Jesus-InC/Sistema-Domotico-Inteligente/docs/pcb/docs/Esquematico.pdf

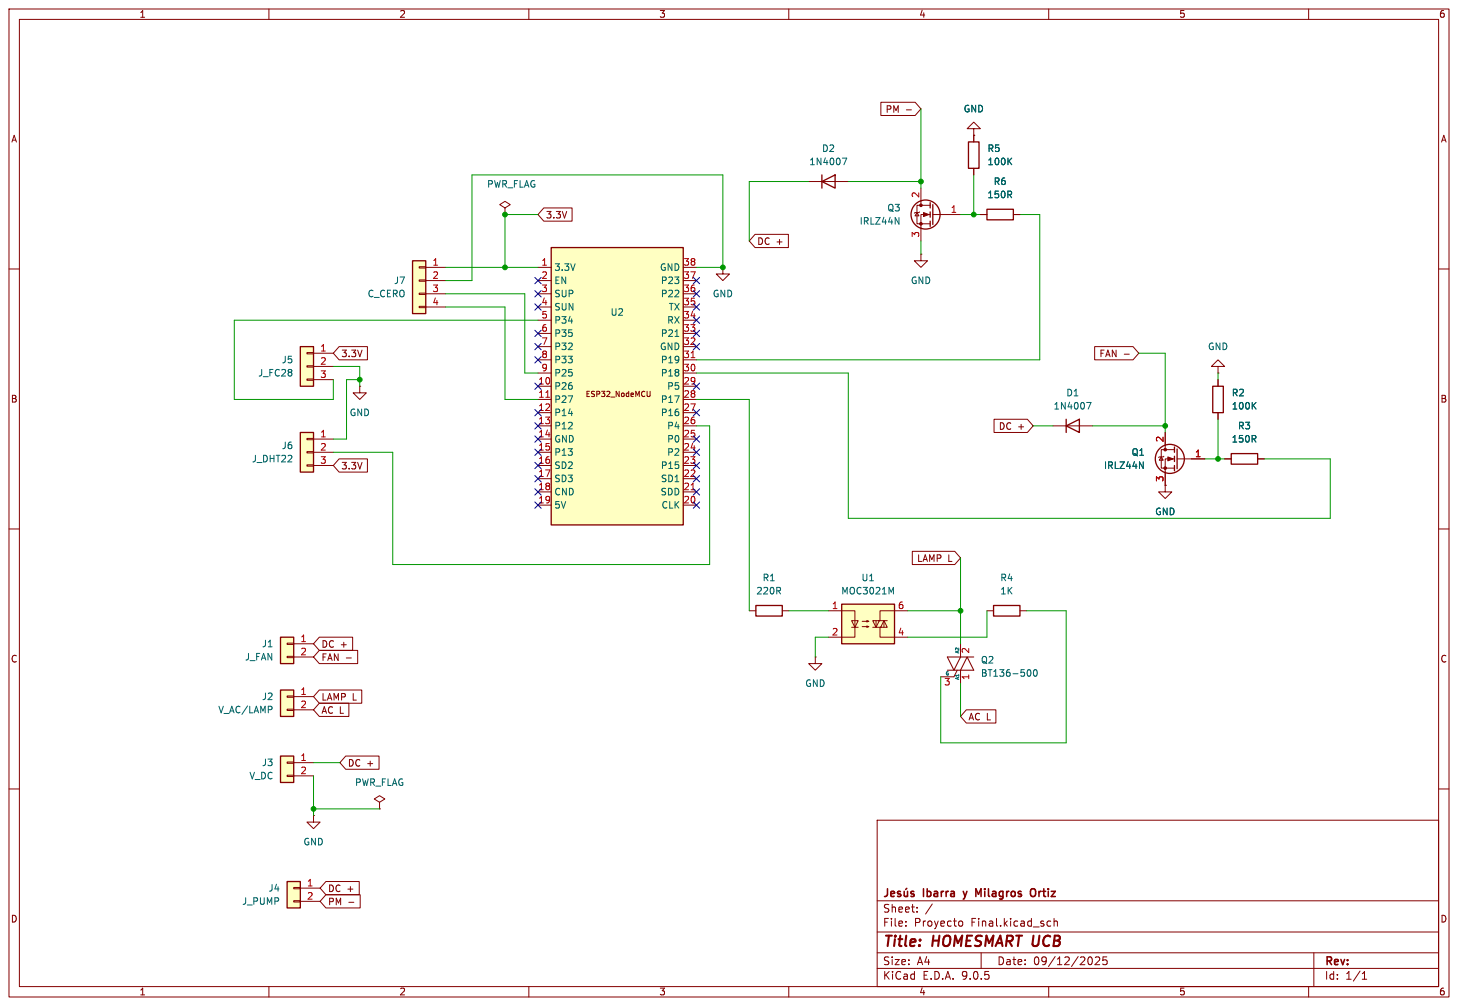
[picture p4: page 1]

Id: 1/1 Title: HOMESMART UCB
