Jesus-InC/Sistema-Domotico-Inteligente/docs/pcb/docs/Proyecto Final-B_Cu.pdf

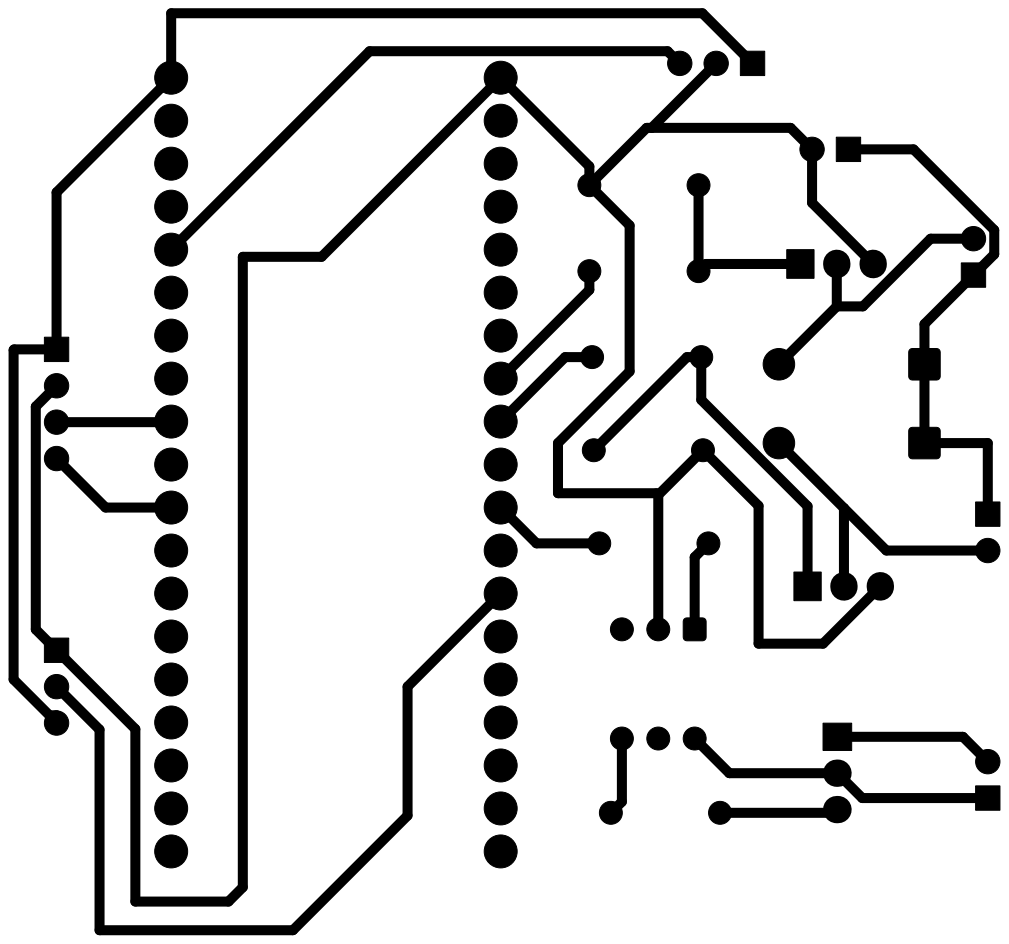
[picture p5: page 1]
